kongr45gpen/POQUITO-panels/README.md

# PocketQube Solar Power Board

A modification of the [Libre Space Foundation QUBIK solar panels](https://gitlab.com/librespacefoundation/qubik/qubik-spb/-/tree/master?ref_type=heads) with a magnetorquer and a coarse sun sensor.
