kongr45gpen/POQUITO-panels/SideSolarPowerBoard.kicad_pcb

## KiCad design SideSolarPowerBoard.kicad_pcb (2023-12-28)

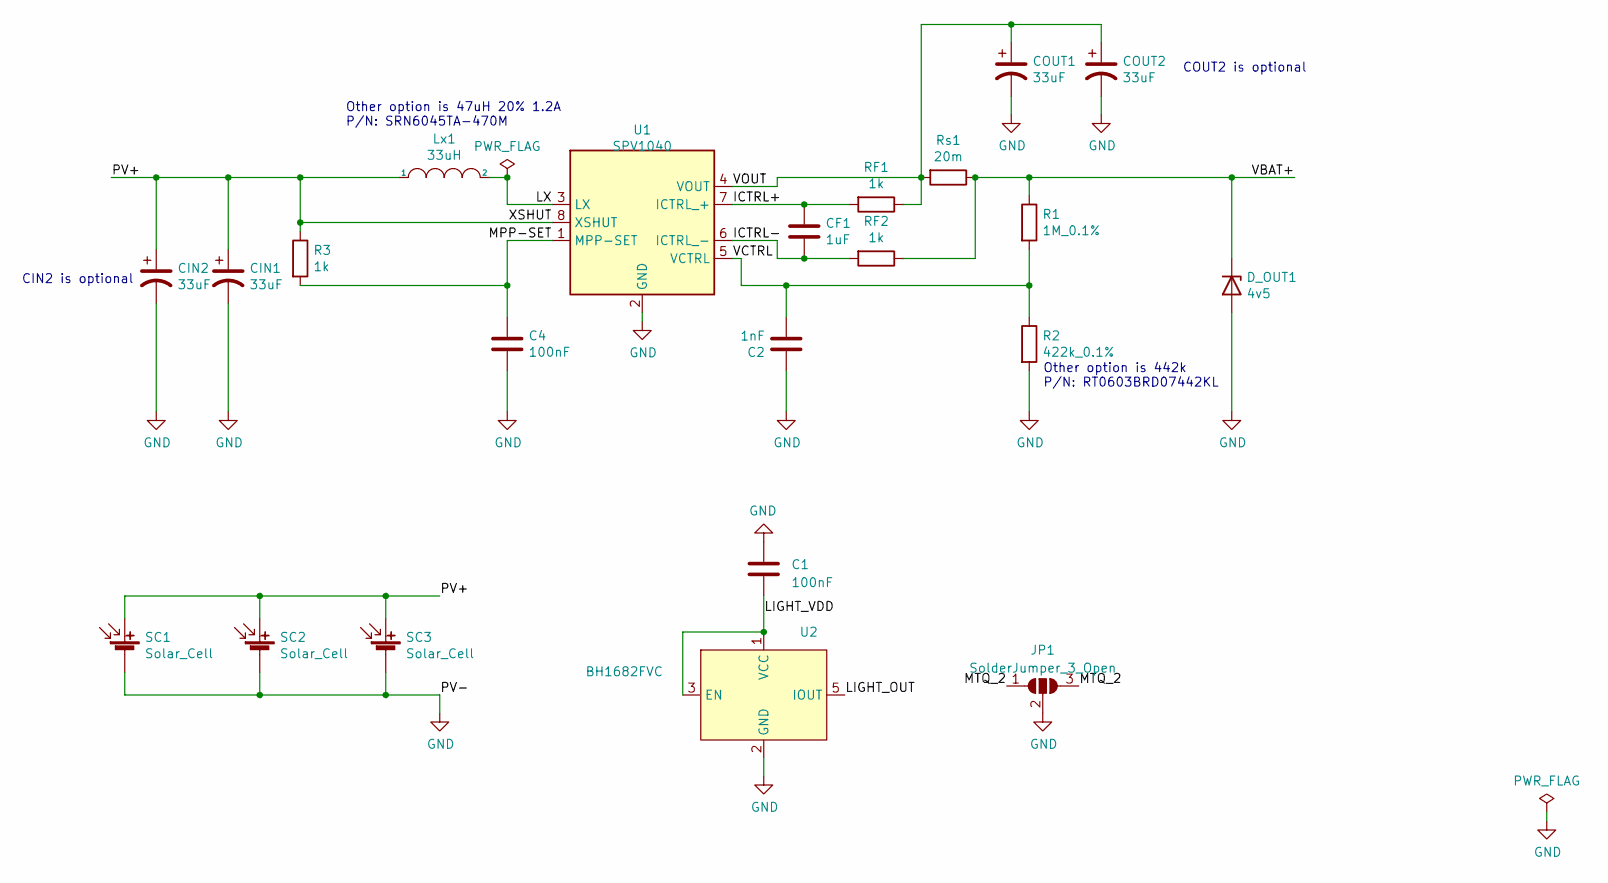
[picture p1: schematic SideSolarPowerBoard.kicad_sch, Side Solar Power Board]

Parts:
C1: 100nF; C_0402_1005Metric_Pad0.74x0.62mm_HandSolder; MPN C0402C104K8RACTU
C2: 1nF; C_0603_1608Metric; MPN C0603C102J8HACTU
C4: 100nF; C_0603_1608Metric; MPN C0603C104K8RACTU
CF1: 1uF; C_0603_1608Metric; MPN C0603C105M8RACAUTO
CIN1, CIN2: 33uF; C_0805_2012Metric; MPN C2012X5R1A336M125AC
COUT1, COUT2: 33uF; C_0805_2012Metric; MPN C2012X5R1A336M125AC
D_OUT1: 4v5; DO-222AA; MPN SMM4F5.0A-TR
JP1: SolderJumper_3_Open; SolderJumper-3_P1.3mm_Open_RoundedPad1.0x1.5mm_NumberLabels
Lx1: 33uH; L_Bourns_SRN6045TA; MPN SRN6045TA-330M
R1: 1M_0.1%; R_0603_1608Metric; MPN RN73H1JTTD1004B25
R2: 422k_0.1%; R_0603_1608Metric; MPN RN73H1JTTD4223B25
R3: 1k; R_0603_1608Metric; MPN CRCW06031K00FKEA
RF1, RF2: 1k; R_0603_1608Metric; MPN CRCW06031K00FKEA
Rs1: 20m; R_0603_1608Metric; MPN RCWE060320L0FQEA
SC1, SC2, SC3: Solar_Cell; SM141K04LV; MPN SM141K04LV
U1: SPV1040; TSSOP-8_4.4x3mm_P0.65mm; MPN SPV1040TTR
U2: BH1682FVC; WSOF-5; MPN BH1682FVC-TR

Connections:
/ICTRL+: CF1.1, RF1.2, U1.7 (ICTRL_+)
/ICTRL-: CF1.2, RF2.2, U1.6 (ICTRL_-)
/LIGHT_OUT: U2.5 (IOUT)
/LIGHT_VDD: C1.1, U2.1 (VCC), U2.3 (EN)
/LX: Lx1.2, U1.3 (LX)
/MPP-SET: C4.1, R3.2, U1.1 (MPP-SET)
/MTQ_2: JP1.1 (A), JP1.3 (B)
/PV+: CIN1.1, CIN2.1, Lx1.1, R3.1, SC1.1 (+), SC2.1 (+), SC3.1 (+), U1.8 (XSHUT)
/VBAT+: D_OUT1.1 (K), R1.1, RF2.1, Rs1.1
/VCTRL: C2.2, R1.2, R2.1, U1.5 (VCTRL)
/VOUT: COUT1.1, COUT2.1, RF1.1, Rs1.2, U1.4 (VOUT)
GND: C1.2, C2.1, C4.2, CIN1.2, CIN2.2, COUT1.2, COUT2.2, D_OUT1.2 (A), JP1.2 (C), R2.2, SC1.2 (-), SC2.2 (-), SC3.2 (-), U1.2 (GND), U2.2 (GND)

Notes on the sheet:
Other option is 47uH 20% 1.2A P/N: SRN6045TA-470M
CIN2 is optional
COUT2 is optional
Other option is 442k P/N: RT0603BRD07442KL

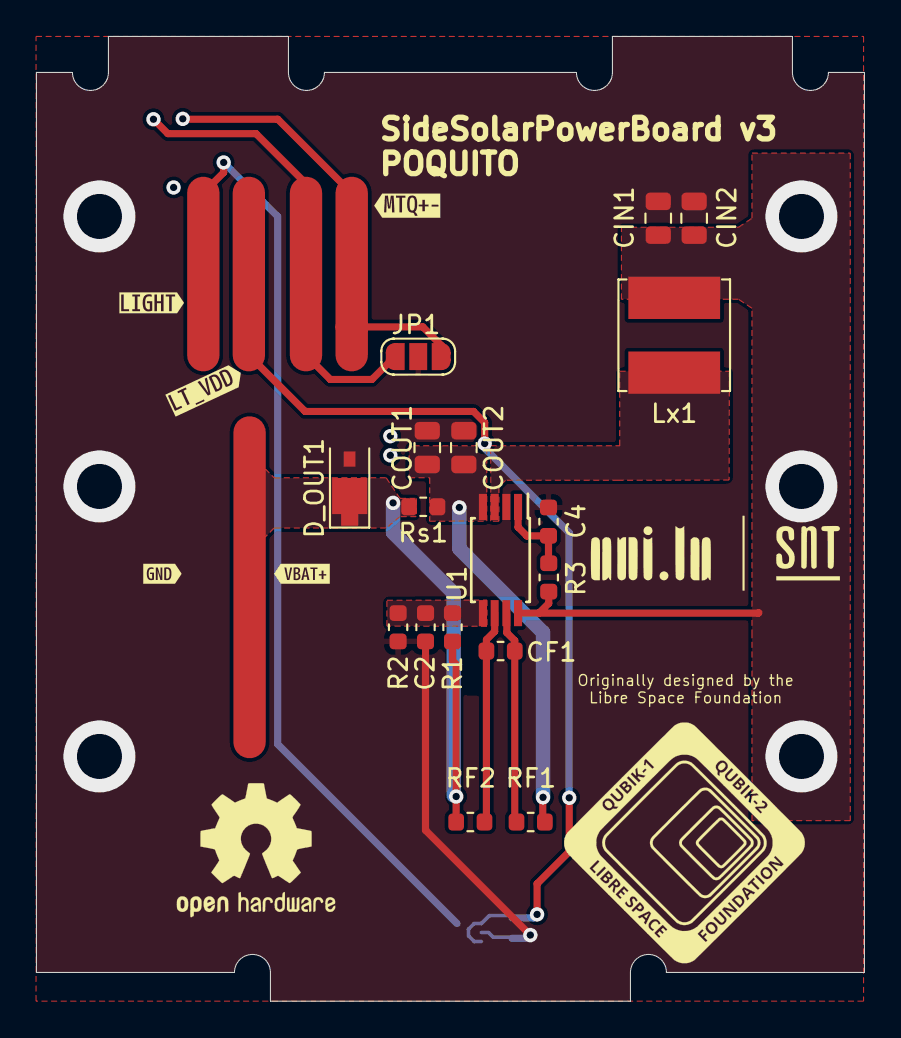
[picture p2: board SideSolarPowerBoard.kicad_pcb from above]

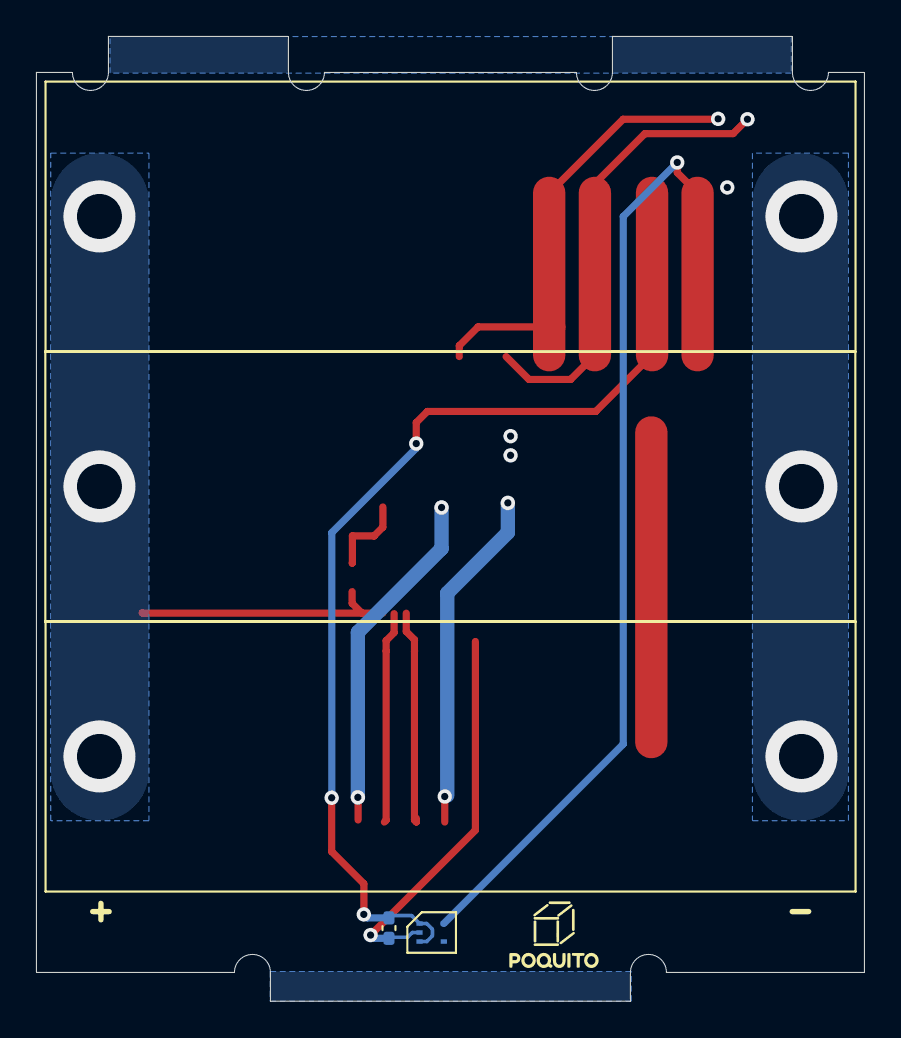
[picture p3: board SideSolarPowerBoard.kicad_pcb from below]

Board: 6 copper layers, 46.0 x 53.6 mm, 27 parts (5 on the bottom side), 11 nets.

Other parts of the board:
kibuzzard-64FE2F6D: G***; kibuzzard-64FE2F6D
kibuzzard-64FE2F42: G***; kibuzzard-64FE2F42
kibuzzard-658D61DC: G***; kibuzzard-658D61DC
kibuzzard-658D6171: G***; kibuzzard-658D6171
kibuzzard-658D6185: G***; kibuzzard-658D6185
