kongr45gpen/POQUITO-panels/(threads)

Thread 6 (2023-09-10):

Magnetorquer

niki100jad, 2023-09-10:
I moved everything around to avoid interference with the magnetorquer. Also, the coil size has been changed compared to the previous version to fit better. We need a connector (input 1, input 2) on the upper part of the board to send pulses to magnetorquers. But I am not sure about cabling in the PocketQube. Feel free to add the connector the way you think is better, and also please let me know if I should change anything.

kongr45gpen, 2023-09-10:
Connections added in https://github.com/kongr45gpen/POQUITO-panels/commit/1c432ae6b6167d89f3beedf9c007300833087981.

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

I also moved some vias closer to the center because KiCad was complaining that they were too close to the MTQ traces.

Closed 2023-09-10.
