kongr45gpen/POQUITO-panels/(commit log)

2023-09-07 Migrate project to KiCad 7
    [SideSolarPowerBoard.kicad_pcb, SideSolarPowerBoard.kicad_sch, SideSolarPowerBoard.sch]
2023-09-07 Quickly add a sensor and a connector
    [SideSolarPowerBoard.kicad_pcb, SideSolarPowerBoard.kicad_sch]
2023-09-10 Move new kicad_pcb file
    [SideSolarPowerBoard.kicad_pcb, SideSolarPowerBoard_MagTrq3.kicad_pcb]
2023-09-10 Add all missing connections
    [SideSolarPowerBoard.kicad_pcb]
2023-09-10 Add logos
    [SideSolarPowerBoard.kicad_pcb]
2023-09-10 Fix connection of MTQ2 to not overlap run
    [SideSolarPowerBoard.kicad_pcb]
2023-12-28 Update to pogo pin ADCS design
    [SideSolarPowerBoard.kicad_pcb, SideSolarPowerBoard.kicad_sch]
2023-12-28 Fix position of Lx
    [SideSolarPowerBoard.kicad_pcb, SideSolarPowerBoard.kicad_sch]
