kongr45gpen/POQUITO-panels/(notices)

Notices in the files:
SideSolarPowerBoard.kicad_sch:
CERN Open Hardware Licence Version 2 - Weakly Reciprocal
